dektronics/printalyzer-timer/hardware/power-board/power-board.kicad_pcb

## KiCad design hardware/power-board/power-board.kicad_pcb (2026-09-14)

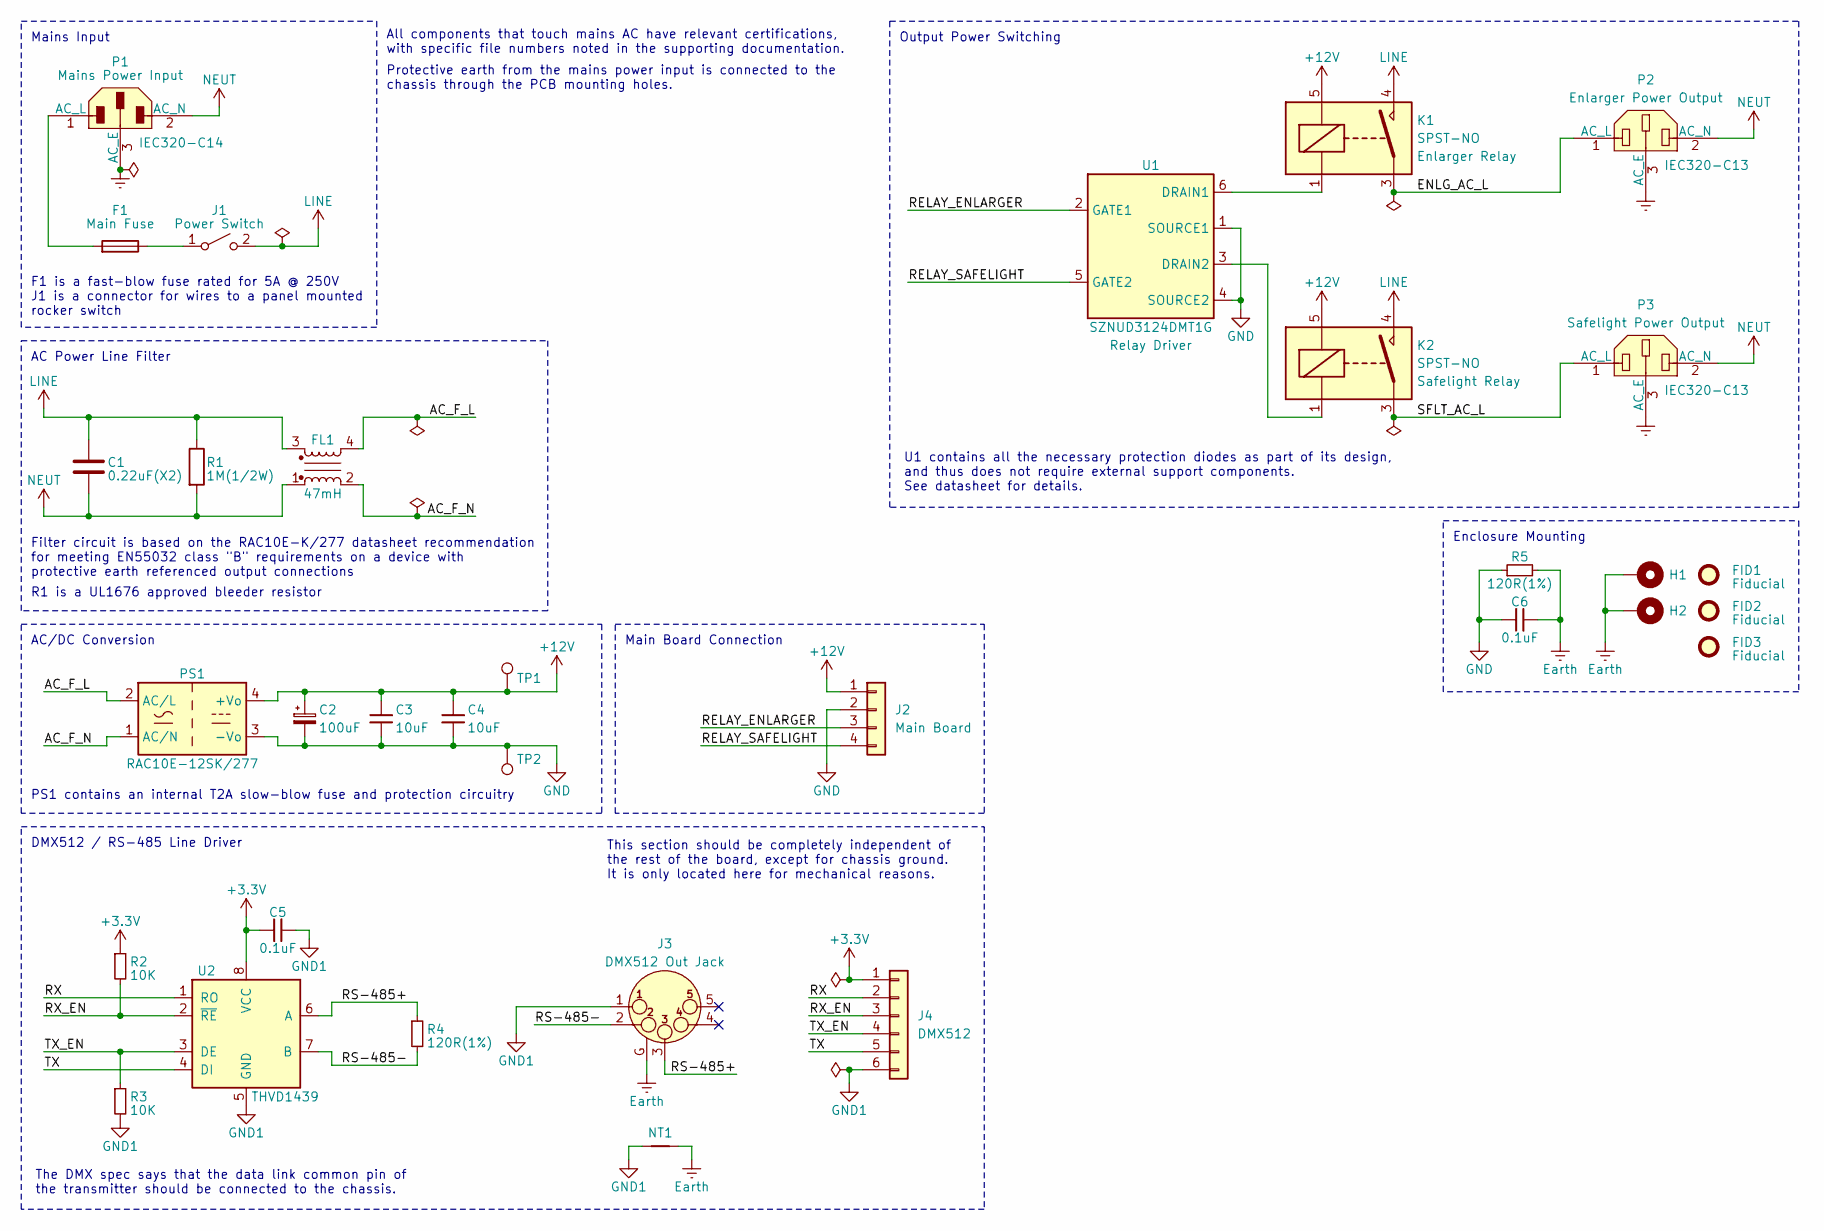
[picture p1: schematic power-board.kicad_sch, Printalyzer - Power Input Board]

Parts:
C1: 0.22uF(X2); C_Rect_L13.0mm_W8.0mm_P10.00mm_Wurth_WCAP-FTX2; Manufacturer PN 890324023028
C2: 100uF; CP_Elec_8x10; Manufacturer PN UWT1H101MNL1GS
C3, C4: 10uF; C_1206_3216Metric; Manufacturer PN CL31B106KBHNNNE
C5, C6: 0.1uF; C_0603_1608Metric; Manufacturer PN CL10B104KA8NNNC
F1: Fuse; Fuseholder_Cylinder-5x20mm_Schurter_FPG5_3101.0050_Horizont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; Manufacturer PN 3101.0050
FID1, FID2, FID3: Fiducial; Fiducial_1mm_Mask2mm
FL1: 47mH; Choke_Schaffner_RN218-02-12.5x10.0mm; Manufacturer PN RN218-0.6-02-47M
H1, H2: MountingHole_Pad; MountingHole_3.5mm_Pad_Via
J1: SW_SPST; Molex_Mini-Fit_Jr_172447_2x01_P4.20mm_Vertical; Manufacturer PN 1724470002
J2: Main Board; JST_PH_S4B-PH-SM4-TB_1x04-1MP_P2.00mm_Horizontal; Manufacturer PN S4B-PH-SM4-TB(LF)(SN)
J3: DMX512 Out Jack; Jack_XLR_Neutrik_NC5FAH_Horizontal; Manufacturer PN NC5FAH
J4: DMX512; JST_SH_SM06B-SRSS-TB_1x06-1MP_P1.00mm_Horizontal; Manufacturer PN SM06B-SRSS-TB(LF)(SN)
K1, K2: SPST-NO; Relay_SPST_Omron_G2RL-1A; Manufacturer PN G2RL-1A DC12
NT1: NetTie_2; NetTie-2_SMD_Pad2.0mm
P1: IEC320-C14; Schurter_GSP1_9101_1; Manufacturer PN GSP1.9101.1
P2, P3: IEC320-C13; Schurter_6182_0033; Manufacturer PN 6182.0033
PS1: RAC10E-12SK/277; Converter_ACDC_RECOM_RAC10E-xxSK_277_THT; Manufacturer PN RAC10E-12SK/277
R1: 1M(1/2W); R_Axial_Vishay_VR37_L9.0mm_D3.2mm_P12.70mm_Horizontal; Manufacturer PN VR37000001004JR500
R2, R3: 10K; R_0603_1608Metric; Manufacturer PN CRCW060310K0JNEA
R4, R5: 120R(1%); R_0805_2012Metric; Manufacturer PN CRCW0805120RFKEA
TP1, TP2: TestPoint; TestPoint_Keystone_5005-5009_Compact; Manufacturer PN 5006
U1: SZNUD3124DMT1G; OnSemi_SC-74-6_1.5x3.0mm_P0.95mm; Manufacturer PN SZNUD3124DMT1G
U2: THVD1439; SOIC-8_3.9x4.9mm_P1.27mm; Manufacturer PN THVD1439DR

Connections:
+3.3V: C5.1, J4.1, R2.1, U2.8 (VCC)
+12V: C2.1, C3.1, C4.1, J2.1, K1.5, K2.5, PS1.4 (+Vo), TP1.1
/AC_F_L: FL1.4, PS1.2 (AC/L)
/AC_F_N: FL1.2, PS1.1 (AC/N)
/ENLG_AC_L: K1.3, P2.1 (AC_L)
/RELAY_ENLARGER: J2.3, U1.2 (GATE1)
/RELAY_SAFELIGHT: J2.4, U1.5 (GATE2)
/RS-485+: J3.3, R4.1, U2.6 (A)
/RS-485-: J3.2, R4.2, U2.7 (B)
/RX: J4.2, U2.1 (RO)
/RX_EN: J4.3, R2.2, U2.2 (~RE)
/SFLT_AC_L: K2.3, P3.1 (AC_L)
/TX: J4.5, U2.4 (DI)
/TX_EN: J4.4, R3.1, U2.3 (DE)
Earth: C6.2, H1.1, H2.1, J3.G, NT1.2, P1.3 (AC_E), P2.3 (AC_E), P3.3 (AC_E), R5.2
GND: C2.2, C3.2, C4.2, C6.1, J2.2, PS1.3 (-Vo), R5.1, TP2.1, U1.1 (SOURCE1), U1.4 (SOURCE2)
GND1: C5.2, J3.1, J4.6, NT1.1, R3.2, U2.5 (GND)
LINE: C1.1, FL1.3, J1.2 (B), K1.4, K2.4, R1.1
NEUT: C1.2, FL1.1, P1.2 (AC_N), P2.2 (AC_N), P3.2 (AC_N), R1.2
unnamed: F1.1, J1.1 (A)
unnamed: F1.2, P1.1 (AC_L)
unnamed: K1.1, U1.6 (DRAIN1)
unnamed: K2.1, U1.3 (DRAIN2)

Notes on the sheet:
This section should be completely independent of the rest of the board, except for chassis ground. It is only located here for mechanical reasons.
All components that touch mains AC have relevant certifications, with specific file numbers noted in the supporting documentation.
Enclosure Mounting
R1 is a UL1676 approved bleeder resistor
Output Power Switching
PS1 contains an internal T2A slow-blow fuse and protection circuitry
U1 contains all the necessary protection diodes as part of its design, and thus does not require external support components. See datasheet for details.
F1 is a fast-blow fuse rated for 5A @ 250V J1 is a connector for wires to a panel mounted rocker switch
Main Board Connection
Protective earth from the mains power input is connected to the chassis through the PCB mounting holes.
The DMX spec says that the data link common pin of the transmitter should be connected to the chassis.
DMX512 / RS-485 Line Driver
Filter circuit is based on the RAC10E-K/277 datasheet recommendation for meeting EN55032 class "B" requirements on a device with protective earth referenced output connections
AC Power Line Filter
Mains Input
AC/DC Conversion

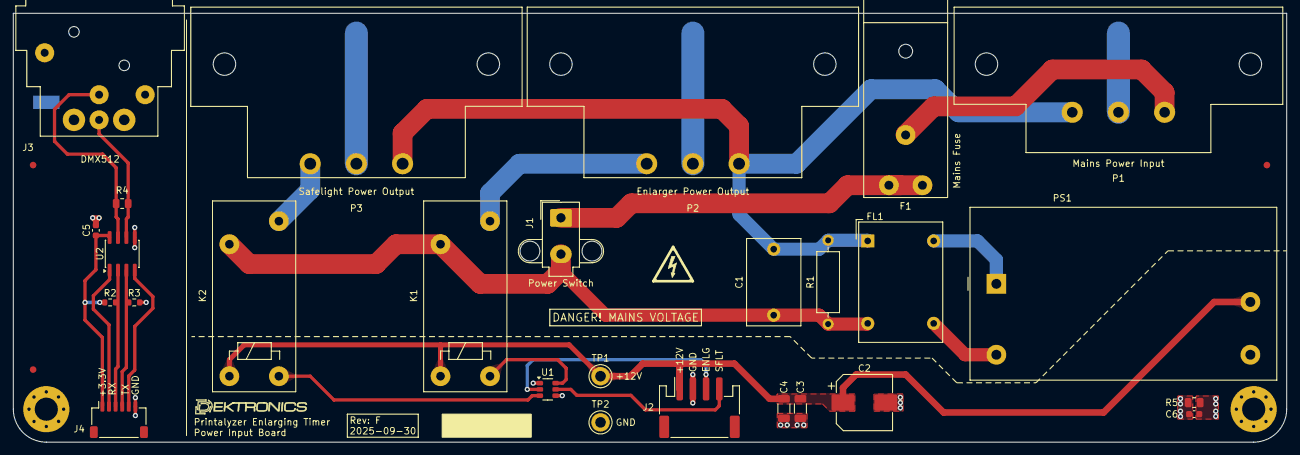
[picture p2: board power-board.kicad_pcb from above]

Board: 2 copper layers, 193.0 x 65.0 mm, 34 parts (1 on the bottom side), 23 nets.

Other parts of the board:
LOGO: G***; Dektronics-logo
