dektronics/printalyzer-timer/hardware/meter-probe/meter-probe.kicad_pcb

## KiCad design hardware/meter-probe/meter-probe.kicad_pcb (2026-08-15)

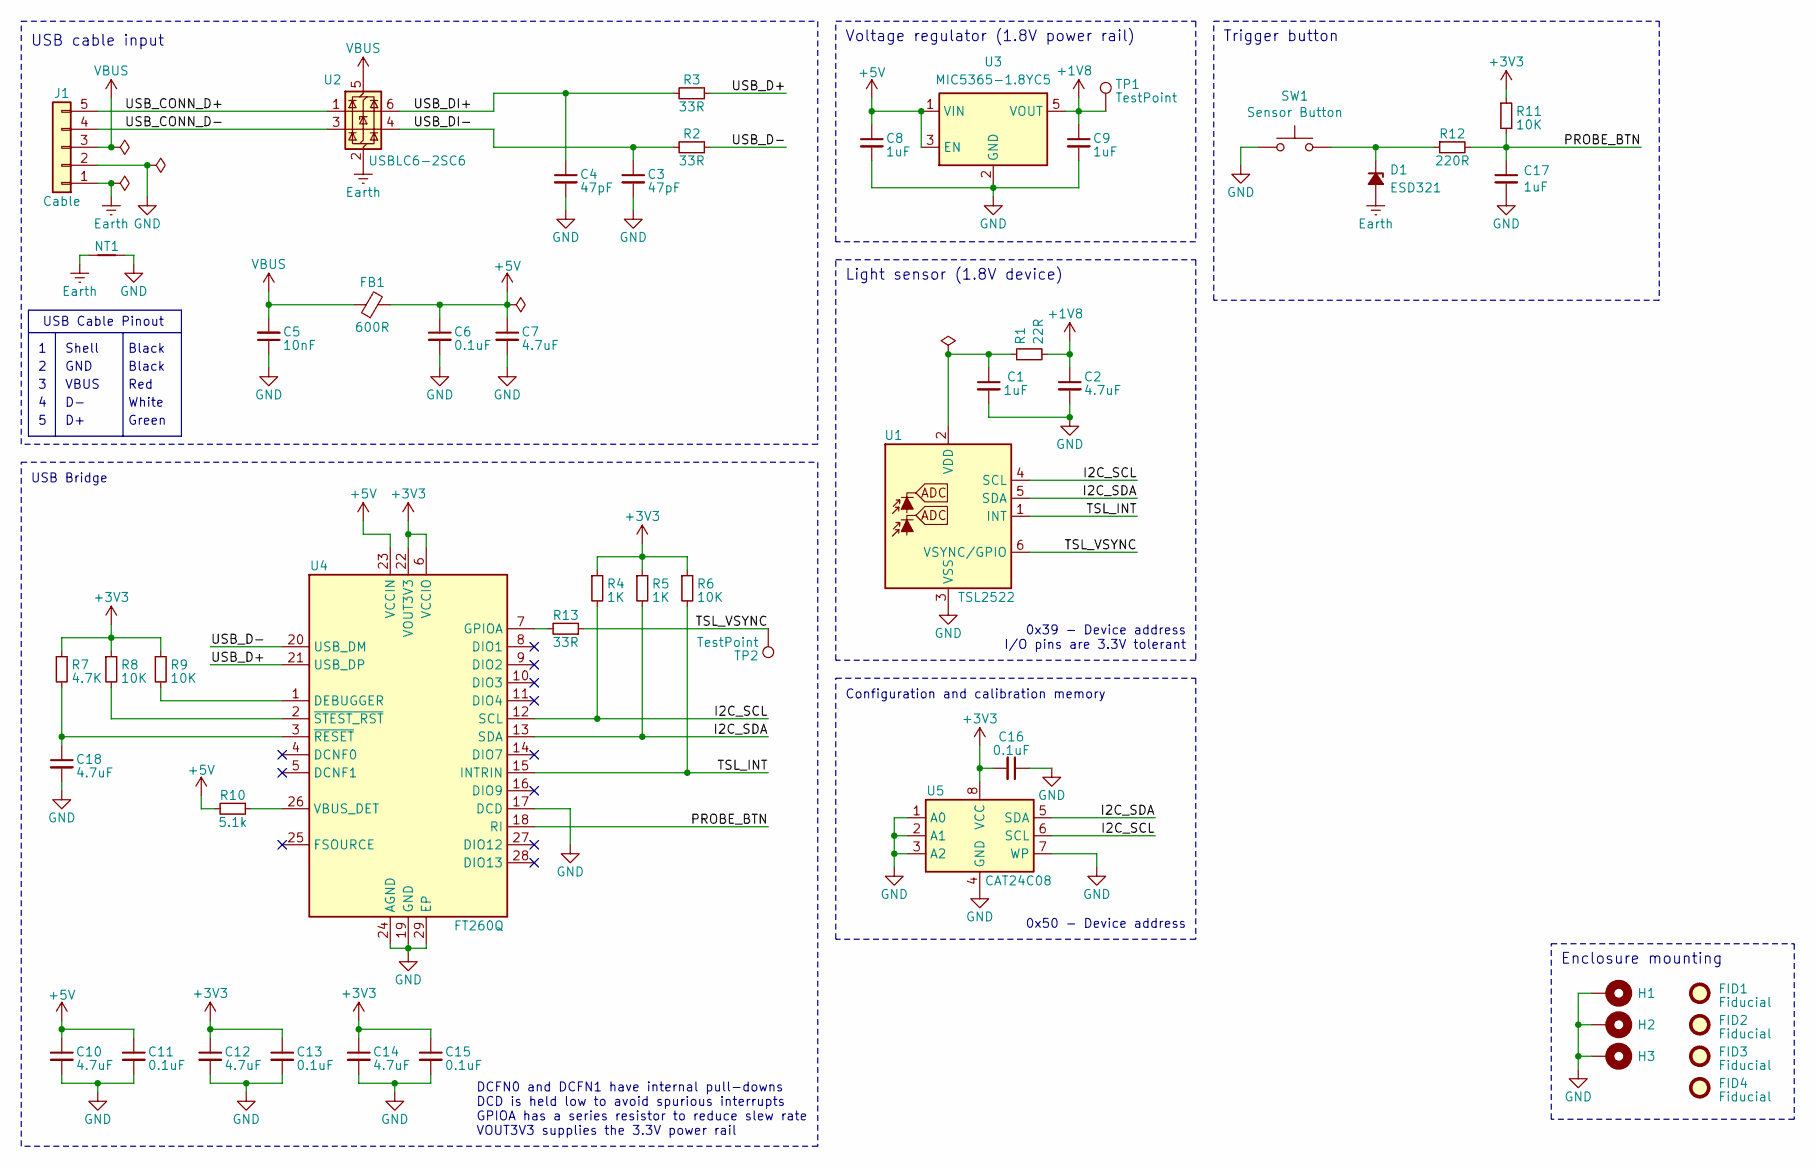
[picture p3: schematic meter-probe.kicad_sch, Printalyzer - Meter Probe]

Parts:
C1: 1uF; C_0402_1005Metric; Manufacturer PN CL05A105KQ5NNNC
C2: 4.7uF; C_0402_1005Metric; Manufacturer PN CL05A475KQ5NRNC
C3, C4: 47pF; C_0603_1608Metric; Manufacturer PN CC0603JRNPO9BN470
C5: 10nF; C_0603_1608Metric; Manufacturer PN CC0603KRX7R8BB103
C6, C11, C13, C15, C16: 0.1uF; C_0603_1608Metric; Manufacturer PN CL10B104KA8NNNC
C7, C10, C12, C14, C18: 4.7uF; C_0603_1608Metric; Manufacturer PN CL10A475KA8NQNC
C8, C9, C17: 1uF; C_0603_1608Metric; Manufacturer PN CL10B105KA8NNNC
D1: ESD321; D_TI_SOD-523_DYA0002A; Manufacturer PN ESD321DYAR
FB1: 600R; L_0603_1608Metric; Manufacturer PN 742792651
FID1, FID2, FID3, FID4: Fiducial; Fiducial_1mm_Mask2mm
H1, H2, H3: MountingHole_Pad; MountingHole_2.7mm_M2.5_Pad_Via
J1: Cable; JST_PH_B5B-PH-SM4-TB_1x05-1MP_P2.00mm_Vertical; Manufacturer PN B5B-PH-SM4-TB
NT1: NetTie_2; NetTie-2_SMD_Pad0.5mm
R1: 22R; R_0402_1005Metric; Manufacturer PN AC0402JR-0722RL
R2, R3, R13: 33R; R_0603_1608Metric; Manufacturer PN RC0603JR-0733RL
R4, R5: 1K; R_0603_1608Metric; Manufacturer PN CRCW06031K00JNEA
R6, R8, R9, R11: 10K; R_0603_1608Metric; Manufacturer PN CRCW060310K0JNEA
R7: 4.7K; R_0603_1608Metric; Manufacturer PN RC0603JR-074K7L
R10: 5.1k; R_0603_1608Metric; Manufacturer PN RC0603JR-075K1L
R12: 220R; R_0603_1608Metric; Manufacturer PN RC0603JR-07220RL
SW1: Sensor Button; SW_Key_6425_0101; Manufacturer PN 6425.0101
TP1, TP2: TestPoint; TestPoint_Pad_D1.0mm
U1: TSL2522; AMS_TSL2522_OLGA-6_2x1mm_P0.65mm; Manufacturer PN TSL25223
U2: USBLC6-2SC6; SOT-23-6; Manufacturer PN USBLC6-2SC6
U3: MIC5365-1.8YC5; SOT-353_SC-70-5; Manufacturer PN MIC5365-1.8YC5-TR
U4: FT260Q; FTDI_WQFN-28-1EP_5x5mm_P0.5mm_EP3.3x3.3mm; Manufacturer PN FT260Q-R
U5: CAT24C08; TSSOP-8_4.4x3mm_P0.65mm; Manufacturer PN CAT24C08YI-GT3

Connections:
+1V8: C2.1, C9.1, R1.2, TP1.1 (1_1), U3.5 (VOUT)
+3V3: C12.1, C13.1, C14.1, C15.1, C16.2, R4.1, R5.1, R6.1, R7.1, R8.1, R9.1, R11.1, U4.6 (VCCIO), U4.22 (VOUT3V3), U5.8 (VCC)
+5V: C6.1, C7.1, C8.1, C10.1, C11.1, FB1.2, R10.2, U3.1 (VIN), U3.3 (EN), U4.23 (VCCIN)
/I2C_SCL: R4.2, U1.4 (SCL), U4.12 (SCL), U5.6 (SCL)
/I2C_SDA: R5.2, U1.5 (SDA), U4.13 (SDA), U5.5 (SDA)
/PROBE_BTN: C17.1, R11.2, R12.2, U4.18 (RI)
/TSL_INT: R6.2, U1.1 (INT), U4.15 (INTRIN)
/TSL_VSYNC: R13.1, TP2.1 (1_1), U1.6 (VSYNC/GPIO)
/USB_CONN_D+: J1.5, U2.1 (I/O1)
/USB_CONN_D-: J1.4, U2.3 (I/O2)
/USB_D+: R3.1, U4.21 (USB_DP)
/USB_D-: R2.1, U4.20 (USB_DM)
/USB_DI+: C4.1, R3.2, U2.6 (I/O1)
/USB_DI-: C3.1, R2.2, U2.4 (I/O2)
Earth: D1.1 (A), J1.1, NT1.2, U2.2 (GND)
GND: C1.2, C2.2, C3.2, C4.2, C5.1, C6.2, C7.2, C8.2, C9.2, C10.2, C11.2, C12.2, C13.2, C14.2, C15.2, C16.1, C17.2, C18.2, H1.1 (1_1), H2.1 (1_1), H3.1 (1_1), J1.2, NT1.1, SW1.1, U1.3 (VSS), U3.2 (GND), U4.17 (DCD), U4.19 (GND), U4.24 (AGND), U4.29 (EP), U5.1 (A0), U5.2 (A1), U5.3 (A2), U5.4 (GND), U5.7 (WP)
unnamed: D1.2 (K), R12.1, SW1.2
unnamed: C1.1, R1.1, U1.2 (VDD)
unnamed: R9.2, U4.1 (DEBUGGER)
unnamed: R13.2, U4.7 (GPIOA)
unnamed: R10.1, U4.26 (VBUS_DET)
unnamed: C18.1, R7.2, U4.3 (~RESET)
unnamed: R8.2, U4.2 (~STEST_RST)
VBUS: C5.2, FB1.1, J1.3, U2.5 (VBUS)

Notes on the sheet:
USB Cable Pinout
GND
Light sensor (1.8V device)
White
0x50 - Device address
USB Bridge
Black
Red
Green
Configuration and calibration memory
VBUS
Voltage regulator (1.8V power rail)
Shell
0x39 - Device address I/O pins are 3.3V tolerant
Enclosure mounting
USB cable input
DCFN0 and DCFN1 have internal pull-downs DCD is held low to avoid spurious interrupts GPIOA has a series resistor to reduce slew rate VOUT3V3 supplies the 3.3V power rail
Trigger button

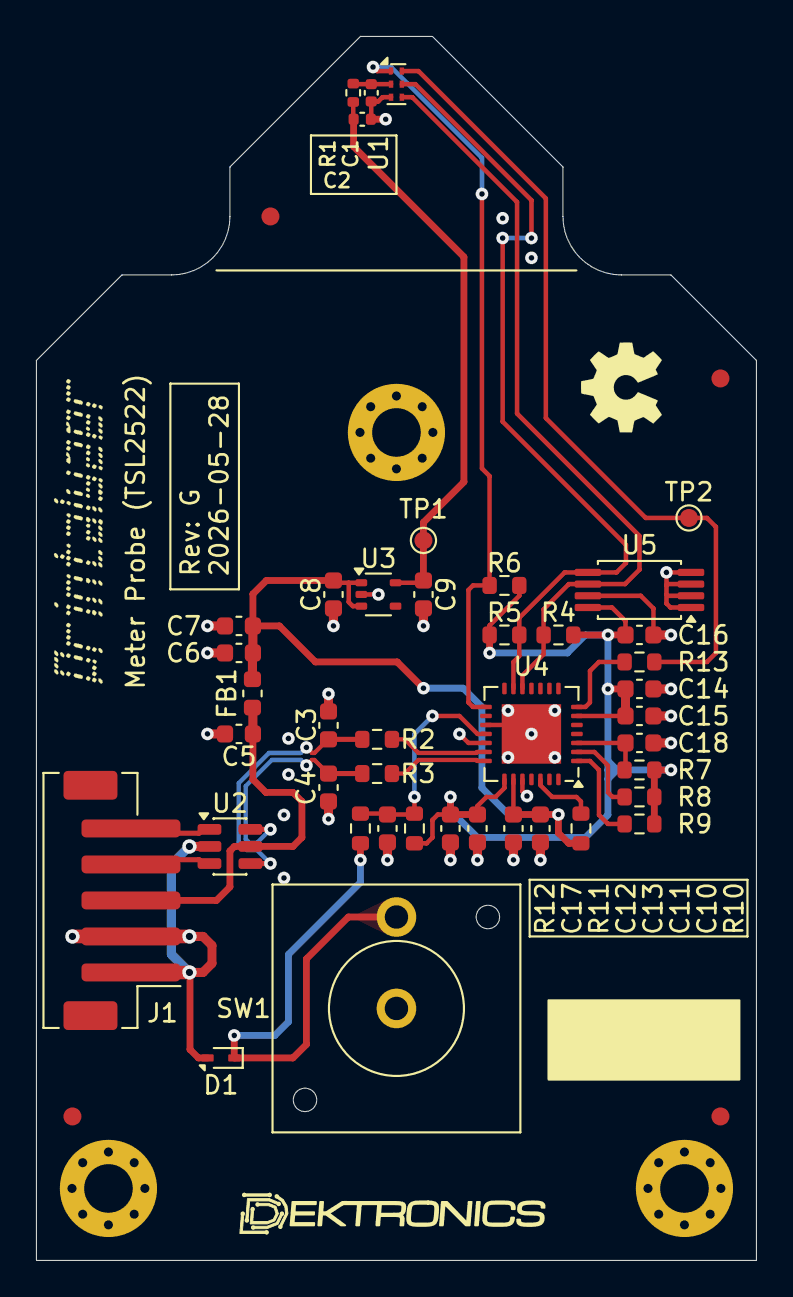
[picture p4: board meter-probe.kicad_pcb from above]

Board: 4 copper layers, 40.0 x 68.0 mm, 51 parts (0 on the bottom side), 24 nets.

Other parts of the board:
LOGO: G***; Dektronics-logo
