dektronics/printalyzer-timer/hardware/densistick/densistick.kicad_pcb

## KiCad design hardware/densistick/densistick.kicad_pcb (2026-08-07)

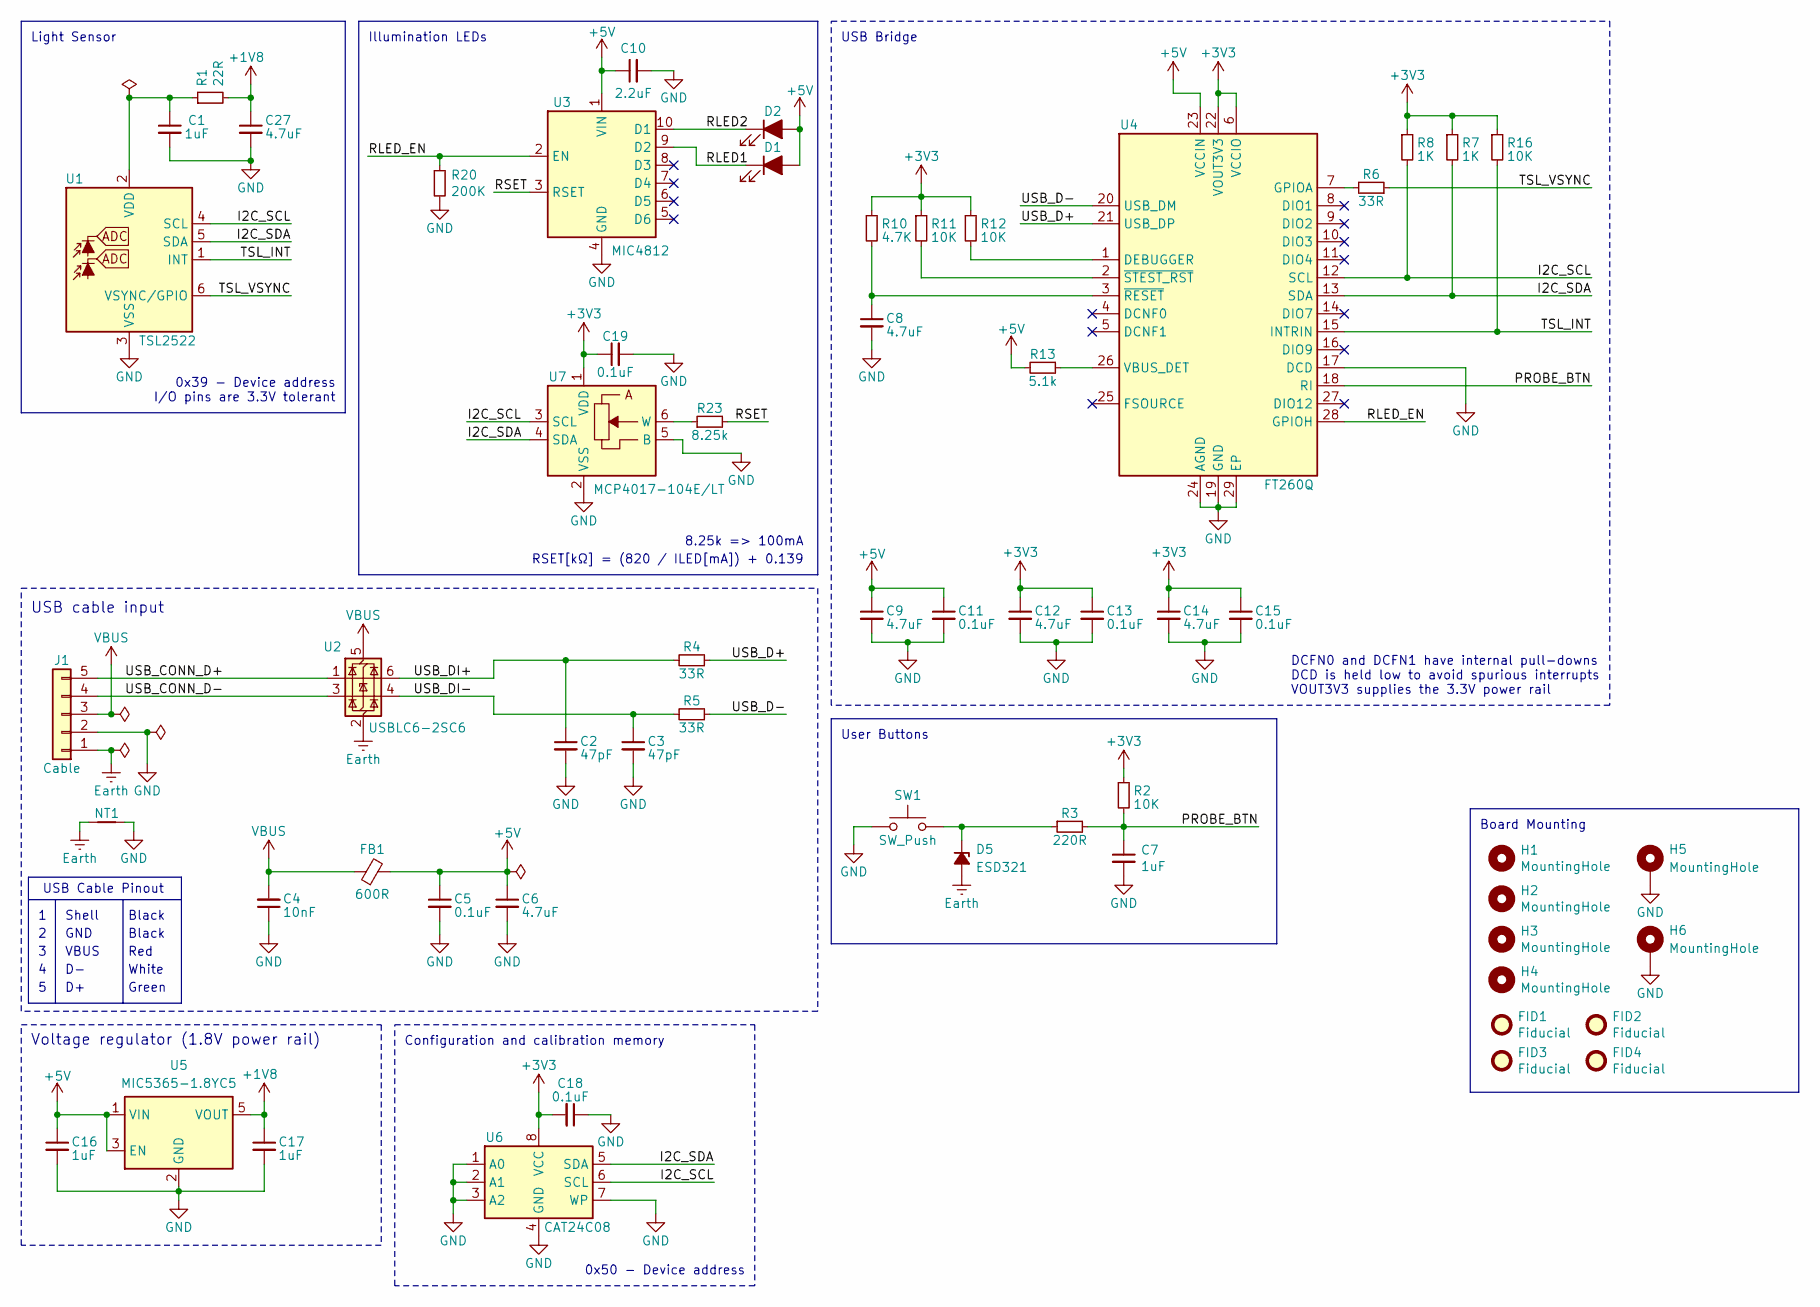
[picture p5: schematic densistick.kicad_sch, Printalyzer DensiStick]

Parts:
C1: 1uF; C_0402_1005Metric; Manufacturer PN CL05A105KQ5NNNC
C2, C3: 47pF; C_0603_1608Metric; Manufacturer PN CC0603JRNPO9BN470
C4: 10nF; C_0603_1608Metric; Manufacturer PN CC0603KRX7R8BB103
C5, C11, C13, C15, C18, C19: 0.1uF; C_0603_1608Metric; Manufacturer PN CL10B104KA8NNNC
C6, C8, C9, C12, C14: 4.7uF; C_0603_1608Metric; Manufacturer PN CL10A475KA8NQNC
C7, C16, C17: 1uF; C_0603_1608Metric; Manufacturer PN CL10B105KA8NNNC
C10: 2.2uF; C_0603_1608Metric; Manufacturer PN CL10B225KP8NNNC
C27: 4.7uF; C_0402_1005Metric; Manufacturer PN CL05A475KQ5NRNC
D1, D2: LED; SunLike_LED_S1S0; Manufacturer PN S1S0-3030309503-0000003S-0P001
D5: ESD321; D_TI_SOD-523_DYA0002A; Manufacturer PN ESD321DYAR
FB1: 600R; L_0603_1608Metric; Manufacturer PN 742792651
FID1, FID2, FID3, FID4: Fiducial; Fiducial_1mm_Mask2mm
H1, H2, H3, H4: MountingHole; MountingHole_2.2mm_M2
H5, H6: MountingHole; MountingHole_2.2mm_M2_Pad_Via
J1: Cable; JST_PH_B5B-PH-SM4-TB_1x05-1MP_P2.00mm_Vertical; Manufacturer PN B5B-PH-SM4-TB
NT1: NetTie_2; NetTie-2_SMD_Pad0.5mm
R1: 22R; R_0402_1005Metric; Manufacturer PN AC0402JR-0722RL
R2, R11, R12, R16: 10K; R_0603_1608Metric; Manufacturer PN CRCW060310K0JNEA
R3: 220R; R_0603_1608Metric; Manufacturer PN RC0603JR-07220RL
R4, R5, R6: 33R; R_0603_1608Metric; Manufacturer PN RC0603JR-0733RL
R7, R8: 1K; R_0603_1608Metric; Manufacturer PN CRCW06031K00JNEA
R10: 4.7K; R_0603_1608Metric; Manufacturer PN RC0603JR-074K7L
R13: 5.1k; R_0603_1608Metric; Manufacturer PN RC0603JR-075K1L
R20: 200K; R_0603_1608Metric; Manufacturer PN CPF0603F200KC1
R23: 8.25k; R_0603_1608Metric; Manufacturer PN CRCW06038K25FKEBC
SW1: SW_Push; SW_TH_Tactile_Omron_B3F-10xx; Manufacturer PN B3F-1052
U1: TSL2522; AMS_TSL2585_OLGA-6_2x1mm_P0.65mm; Manufacturer PN TSL25223
U2: USBLC6-2SC6; SOT-23-6; Manufacturer PN USBLC6-2SC6
U3: MIC4812; Micrel_MSOP-10-1EP_3x3mm_P0.5mm_EP1.73x1.7mm_ThermalVias; Manufacturer PN MIC4812YMME
U4: FT260Q; FTDI_WQFN-28-1EP_5x5mm_P0.5mm_EP3.3x3.3mm; Manufacturer PN FT260Q-R
U5: MIC5365-1.8YC5; SOT-353_SC-70-5; Manufacturer PN MIC5365-1.8YC5-TR
U6: CAT24C08; TSSOP-8_4.4x3mm_P0.65mm; Manufacturer PN CAT24C08YI-GT3
U7: MCP4017-104E/LT; SOT-363_SC-70-6; Manufacturer PN MCP4017T-104E/LT

Connections:
+1V8: C17.1, C27.1, R1.2, U5.5 (VOUT)
+3V3: C12.1, C13.1, C14.1, C15.1, C18.2, C19.1, R2.1, R7.1, R8.1, R10.1, R11.1, R12.1, R16.1, U4.6 (VCCIO), U4.22 (VOUT3V3), U6.8 (VCC), U7.1 (VDD)
+5V: C5.1, C6.1, C9.1, C10.1, C11.1, C16.1, D1.2 (A), D2.2 (A), FB1.2, R13.2, U3.1 (VIN), U4.23 (VCCIN), U5.1 (VIN), U5.3 (EN)
/I2C_SCL: R8.2, U1.4 (SCL), U4.12 (SCL), U6.6 (SCL), U7.3 (SCL)
/I2C_SDA: R7.2, U1.5 (SDA), U4.13 (SDA), U6.5 (SDA), U7.4 (SDA)
/PROBE_BTN: C7.1, R2.2, R3.2, U4.18 (RI)
/RLED1: D1.1 (K), U3.9 (D2)
/RLED2: D2.1 (K), U3.10 (D1)
/RLED_EN: R20.1, U3.2 (EN), U4.28 (GPIOH)
/RSET: R23.2, U3.3 (RSET)
/TSL_INT: R16.2, U1.1 (INT), U4.15 (INTRIN)
/TSL_VSYNC: R6.1, U1.6 (VSYNC/GPIO)
/USB_CONN_D+: J1.5, U2.1 (I/O1)
/USB_CONN_D-: J1.4, U2.3 (I/O2)
/USB_D+: R4.1, U4.21 (USB_DP)
/USB_D-: R5.1, U4.20 (USB_DM)
/USB_DI+: C2.1, R4.2, U2.6 (I/O1)
/USB_DI-: C3.1, R5.2, U2.4 (I/O2)
Earth: D5.1 (A), J1.1, NT1.2, U2.2 (GND)
GND: C1.2, C2.2, C3.2, C4.1, C5.2, C6.2, C7.2, C8.2, C9.2, C10.2, C11.2, C12.2, C13.2, C14.2, C15.2, C16.2, C17.2, C18.1, C19.2, C27.2, H5.1 (1_1), H6.1 (1_1), J1.2, NT1.1, R20.2, SW1.1, U1.3 (VSS), U3.4 (GND), U3.11 (EP), U4.17 (DCD), U4.19 (GND), U4.24 (AGND), U4.29 (EP), U5.2 (GND), U6.1 (A0), U6.2 (A1), U6.3 (A2), U6.4 (GND), U6.7 (WP), U7.2 (VSS), U7.5 (B)
unnamed: D5.2 (K), R3.1, SW1.2
unnamed: C1.1, R1.1, U1.2 (VDD)
unnamed: R12.2, U4.1 (DEBUGGER)
unnamed: R6.2, U4.7 (GPIOA)
unnamed: R13.1, U4.26 (VBUS_DET)
unnamed: C8.1, R10.2, U4.3 (~RESET)
unnamed: R11.2, U4.2 (~STEST_RST)
unnamed: R23.1, U7.6 (W)
VBUS: C4.2, FB1.1, J1.3, U2.5 (VBUS)

Notes on the sheet:
Red
Board Mounting
Illumination LEDs
GND
0x50 - Device address
Voltage regulator (1.8V power rail)
RSET[kΩ] = (820 / ILED[mA]) + 0.139
USB cable input
8.25k => 100mA
Black
USB Cable Pinout
Shell
0x39 - Device address I/O pins are 3.3V tolerant
USB Bridge
Green
VBUS
White
Light Sensor
User Buttons
DCFN0 and DCFN1 have internal pull-downs DCD is held low to avoid spurious interrupts VOUT3V3 supplies the 3.3V power rail
Configuration and calibration memory

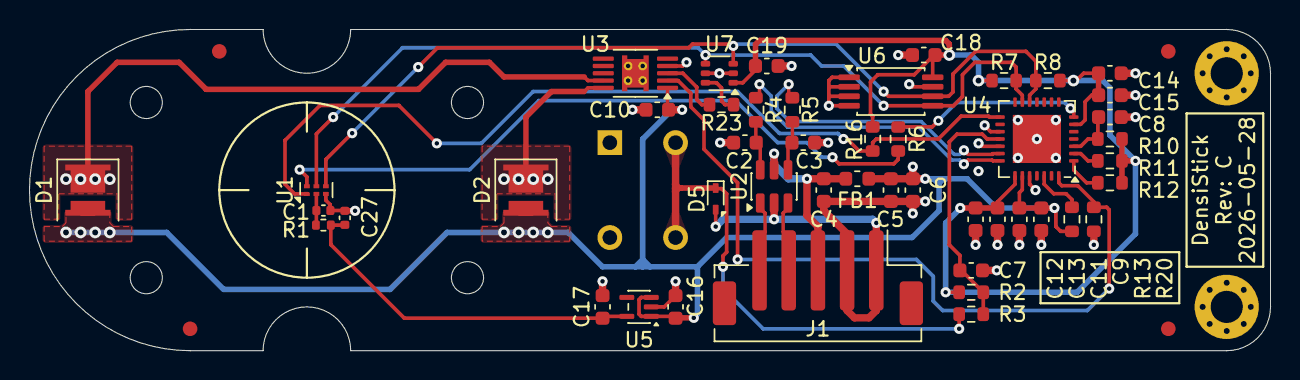
[picture p6: board densistick.kicad_pcb from above]

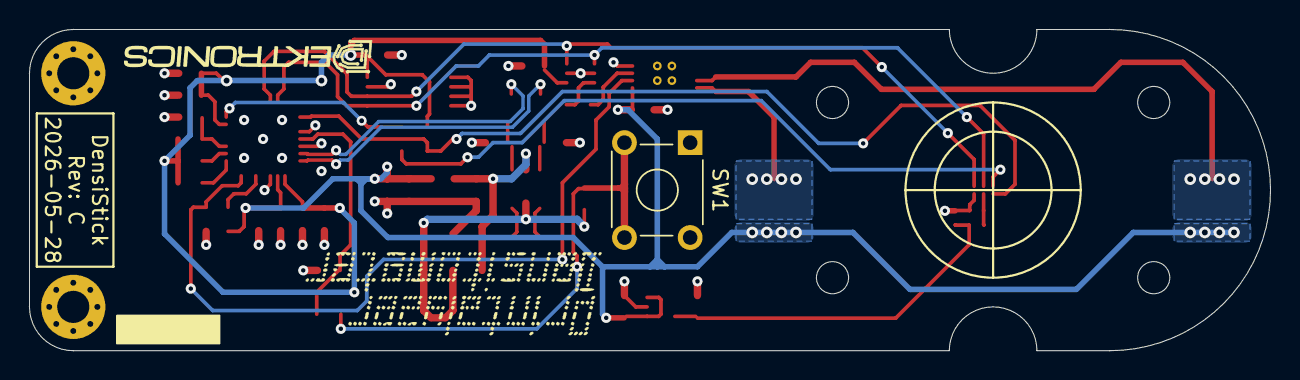
[picture p7: board densistick.kicad_pcb from below]

Board: 4 copper layers, 85.0 x 22.0 mm, 60 parts (6 on the bottom side), 29 nets.

Other parts of the board:
LOGO: G***; Dektronics-logo
